CJoz13/BlinkCloud/(commit log)

2026-10-08 Move per-lamp personalization into secrets.h overrides
    Anniversary date, day/night dial hours, LED ring hour offset, and default
    brightness are now optional #define overrides in secrets.h instead of
    hardcoded constants in cloud_lamp.ino, so no personal date/config has to be
    edited into the shared public source. Anniversary month/day default to 0
    (disabled) until a lamp's secrets.h sets a real date.
    Claude-Session: https://claude.ai/code/session_015vH8ZECCQfxY5Y6sXJZZvE
2026-10-08 Prepare repo for public release
    - Rewrite README: motivation, parts actually used, ESP32-USB-C power
    wiring, signal wiring with 330 ohm data-line resistor, HiveMQ Cloud
    setup and MQTT topics, BLE presence idea, photo of finished lamp
    - License under PolyForm Noncommercial 1.0.0 (no commercial use/resale)
    - Firmware: self-heal WiFi after long outages (radio cycle, last-resort
    reboot); point header comments at README
    - Keep enclosure CAD, CLAUDE.md, zips, and local spreadsheets out of git
    [cloud_lamp.ino]
